davemckelvie/pihat-led-display/pihat-led-display.png

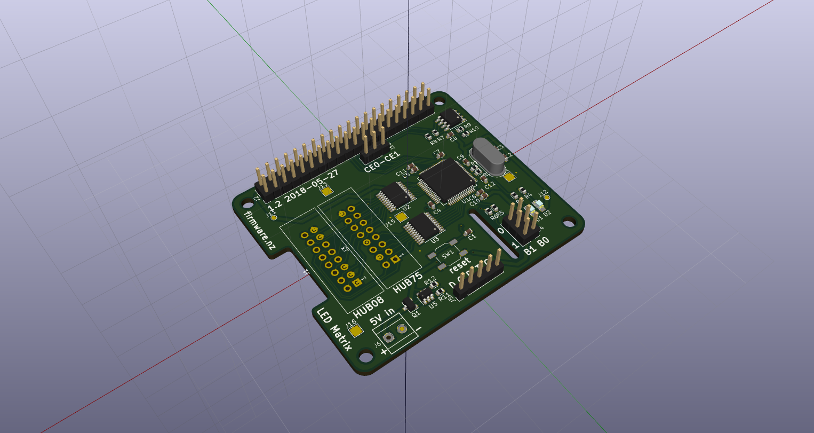
pihat-led-display.png
