davemckelvie/pihat-led-display/pihat-led-display.pdf

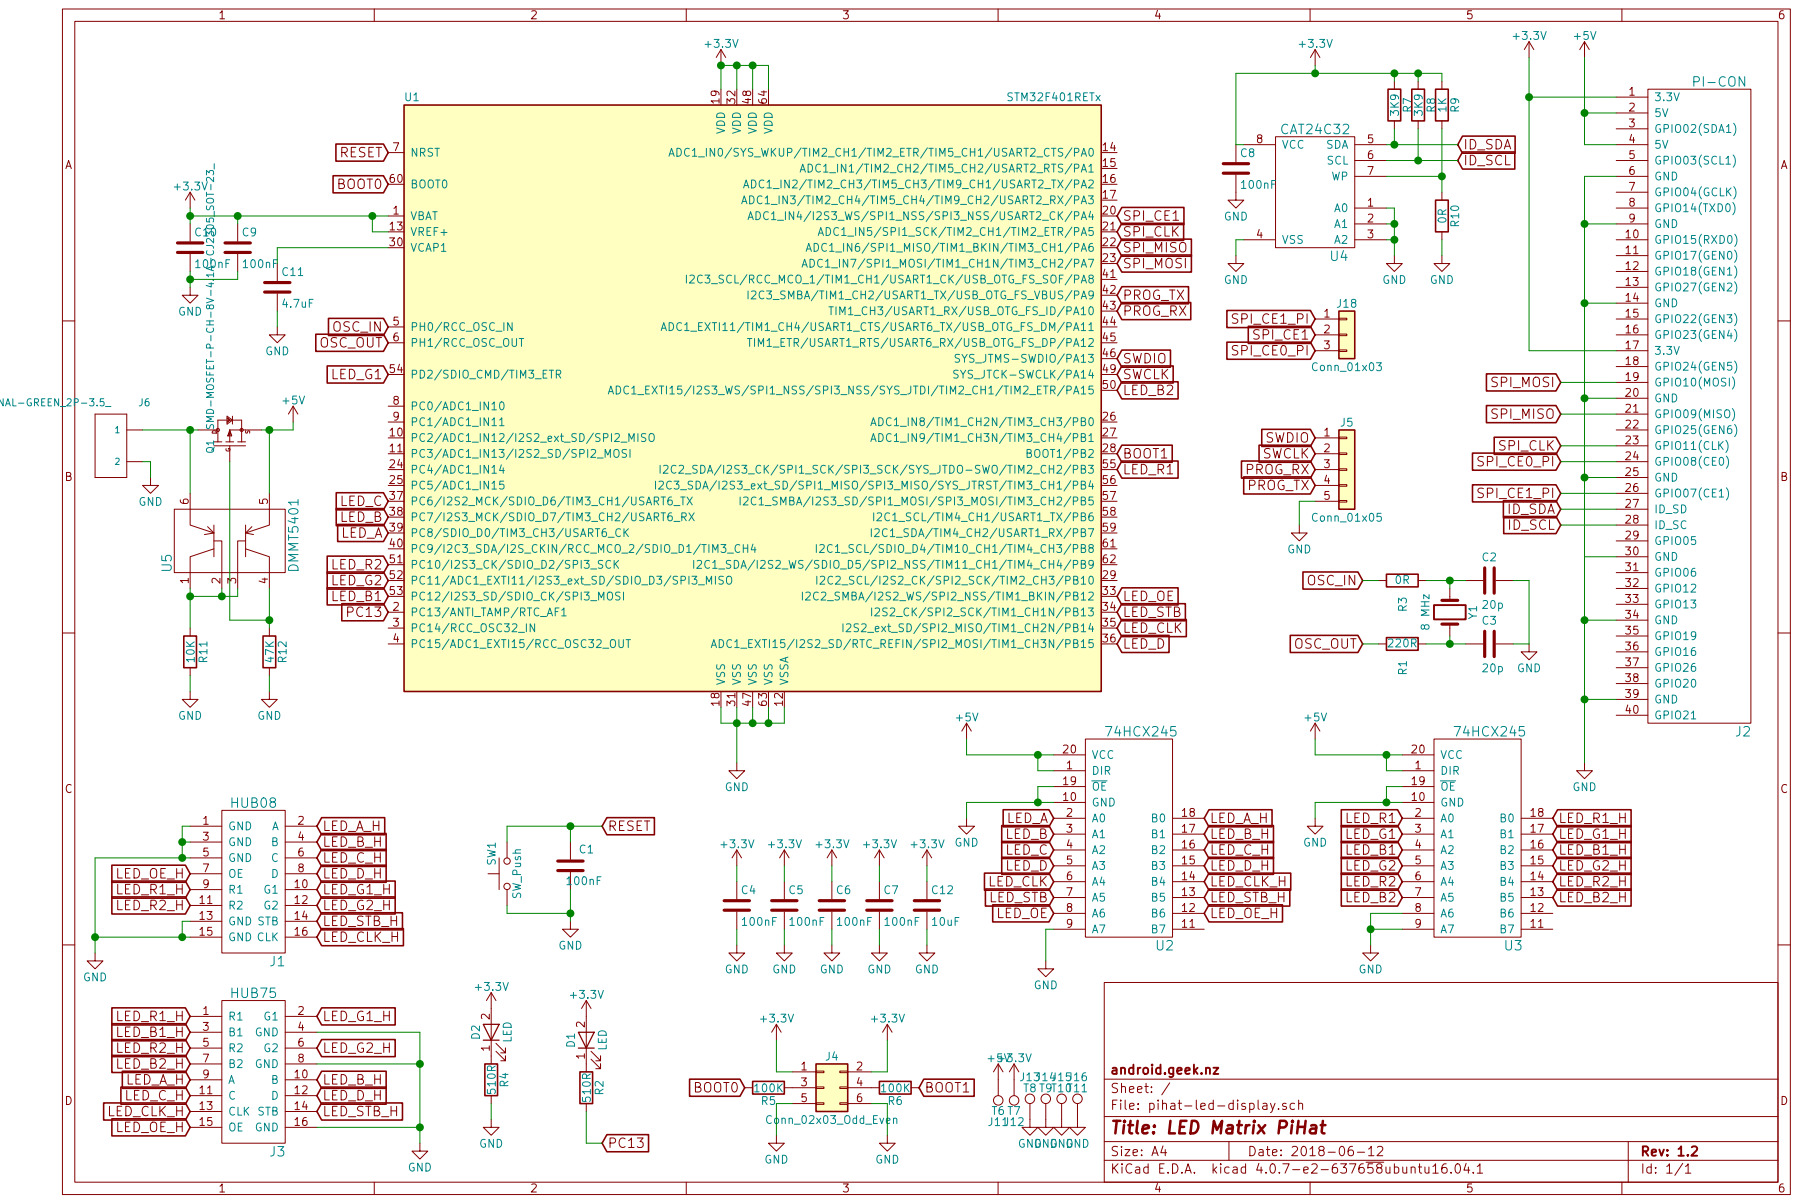
[picture p2: page 1]
