davemckelvie/pihat-led-display/pihat-led-display.kicad_pcb

## KiCad design pihat-led-display.kicad_pcb (2018-08-08)

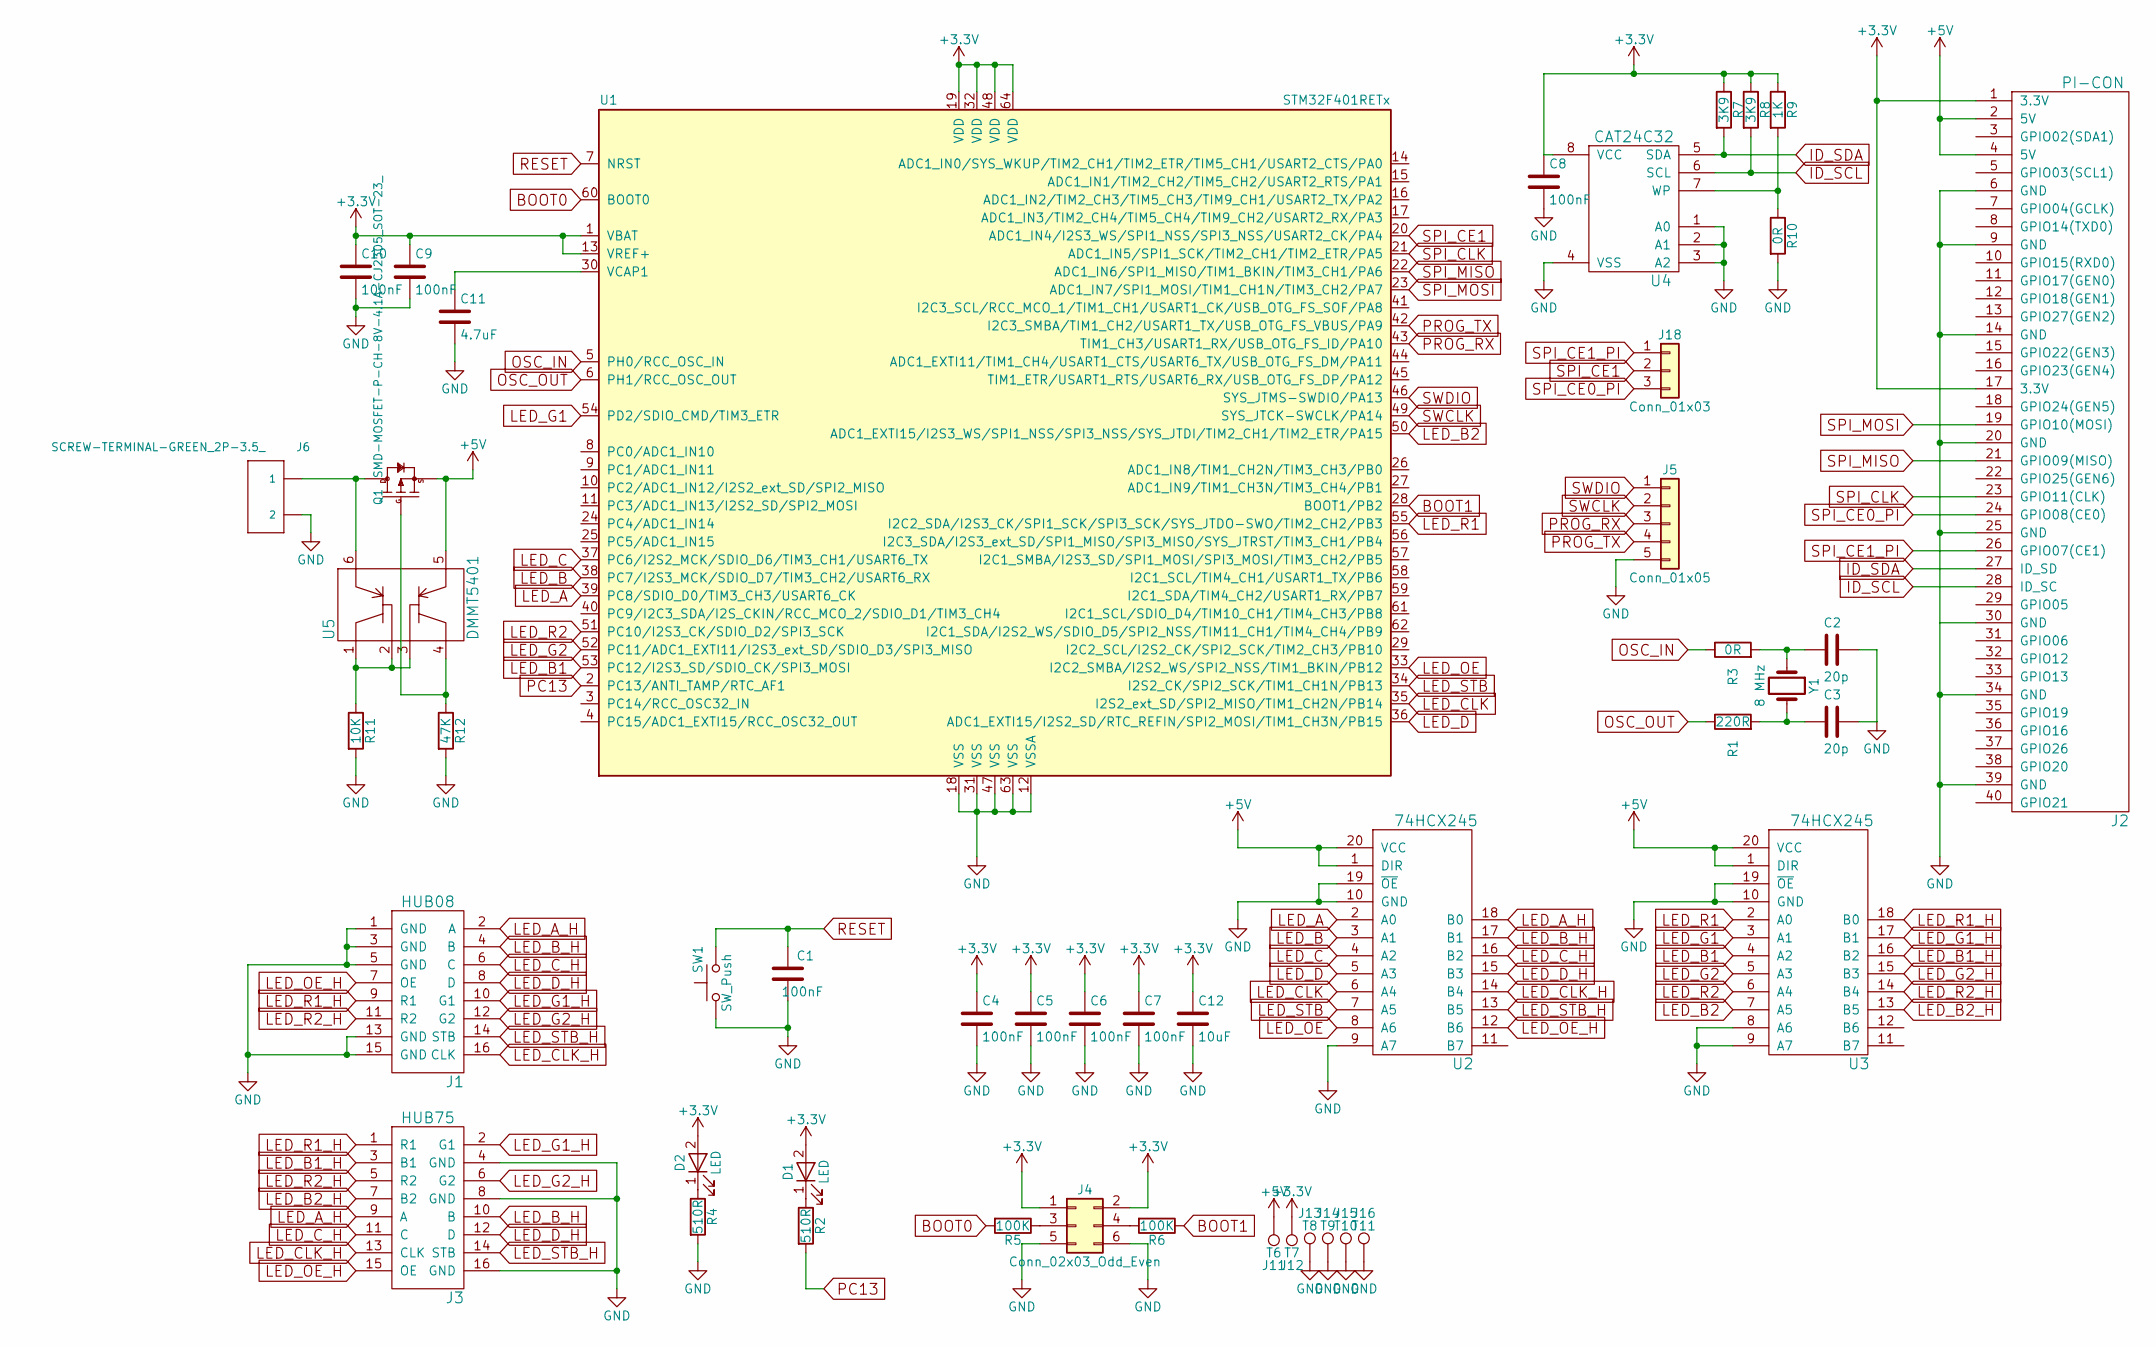
[picture p3: schematic pihat-led-display.sch, LED Matrix PiHat]

Parts:
C1, C4, C5, C6, C7, C8, C9, C10: 100nF; C_0603
C2, C3: 20p; C_0603
C11: 4.7uF; C_0603
C12: 10uF; C_0603
D1, D2: LED; LED_0805
J1: HUB08; IDC-Header_2x08_Pitch2.54mm_Straight
J2: PI-CON; Pin_Header_Straight_2x20_Pitch2.54mm
J3: HUB75; IDC-Header_2x08_Pitch2.54mm_Straight
J4: Conn_02x03_Odd_Even; Pin_Header_Straight_2x03_Pitch2.54mm
J5: Conn_01x05; Pin_Header_Straight_1x05_Pitch2.54mm
J6: SCREW-TERMINAL-GREEN_2P-3.5_; H2-3.5-7.0X7.0MM
J11: T6; Test_Point_Pad_d1.0mm
J12: T7; Test_Point_Pad_d1.0mm
J13: T8; Test_Point_Pad_2.0x2.0mm
J14: T9; Test_Point_Pad_2.0x2.0mm
J15: T10; Test_Point_Pad_2.0x2.0mm
J16: T11; Test_Point_Pad_2.0x2.0mm
J18: Conn_01x03; Pin_Header_Straight_1x03_Pitch2.54mm
Q1: SMD-MOSFET-P-CH-8V-4.1A-CJ2305_SOT-23_; SOT-23; MPN CJ2305
R1: 220R; R_0603
R2, R4: 510R; R_0603
R3, R10: 0R; R_0603
R5, R6: 100K; R_0603
R7, R8: 3K9; R_0603
R9: 1K; R_0603
R11: 10K; R_0603
R12: 47K; R_0603
SW1: SW_Push; SW_SPST_SKQG
U1: STM32F401RETx; LQFP-64_10x10mm_Pitch0.5mm
U2, U3: 74HCX245; TSSOP-20_4.4x6.5mm_Pitch0.65mm
U4: CAT24C32; SOIC-8_3.9x4.9mm_Pitch1.27mm
U5: DMMT5401; SOT-23-6
Y1: 8 MHz; Crystal_HC49-4H_Vertical

Connections:
+3V3: C4.1, C5.1, C6.1, C7.1, C8.1, C9.1, C10.1, C12.1, D1.2 (A), D2.2 (A), J2.1 (3.3V), J2.17 (3.3V), J4.1, J4.2, J12.1, R7.1, R8.1, R9.1, U1.1 (VBAT), U1.13 (VREF+), U1.19 (VDD), U1.32 (VDD), U1.48 (VDD), U1.64 (VDD), U4.8 (VCC)
+5V: J2.2 (5V), J2.4 (5V), J11.1, Q1.2 (S), U2.1 (DIR), U2.20 (VCC), U3.1 (DIR), U3.20 (VCC), U5.5
BOOT0: R5.2, U1.60 (BOOT0)
BOOT1: R6.1, U1.28 (BOOT1/PB2)
GND: C1.1, C2.1, C3.1, C4.2, C5.2, C6.2, C7.2, C8.2, C9.2, C10.2, C11.2, C12.2, J1.1 (GND), J1.3 (GND), J1.5 (GND), J1.13 (GND), J1.15 (GND), J2.6 (GND), J2.9 (GND), J2.14 (GND), J2.20 (GND), J2.25 (GND), J2.34 (GND), J2.39 (GND), J3.4 (GND), J3.8 (GND), J3.16 (GND), J4.5, J4.6, J5.5, J6.2, J13.1, J14.1, J15.1, J16.1, R4.2, R10.2, R11.2, R12.2, SW1.1, U1.12 (VSSA), U1.18 (VSS), U1.31 (VSS), U1.47 (VSS), U1.63 (VSS), U2.9 (A7), U2.10 (GND), U2.19 (~OE), U3.8 (A6), U3.9 (A7), U3.10 (GND), U3.19 (~OE), U4.1 (A0), U4.2 (A1), U4.3 (A2), U4.4 (VSS)
ID_SCL: J2.28 (ID_SC), R8.2, U4.6 (SCL)
ID_SDA: J2.27 (ID_SD), R7.2, U4.5 (SDA)
LED_A: U1.39 (PC8/SDIO_D0/TIM3_CH3/USART6_CK), U2.2 (A0)
LED_A_H: J1.2 (A), J3.9 (A), U2.18 (B0)
LED_B: U1.38 (PC7/I2S3_MCK/SDIO_D7/TIM3_CH2/USART6_RX), U2.3 (A1)
LED_B1: U1.53 (PC12/I2S3_SD/SDIO_CK/SPI3_MOSI), U3.4 (A2)
LED_B1_H: J3.3 (B1), U3.16 (B2)
LED_B2: U1.50 (ADC1_EXTI15/I2S3_WS/SPI1_NSS/SPI3_NSS/S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), U3.7 (A5)
LED_B2_H: J3.7 (B2), U3.13 (B5)
LED_B_H: J1.4 (B), J3.10 (B), U2.17 (B1)
LED_C: U1.37 (PC6/I2S2_MCK/SDIO_D6/TIM3_CH1/USART6_TX), U2.4 (A2)
LED_CLK: U1.35 (I2S2_ext_SD/SPI2_MISO/TIM1_CH2N/PB14), U2.6 (A4)
LED_CLK_H: J1.16 (CLK), J3.13 (CLK), U2.14 (B4)
LED_C_H: J1.6 (C), J3.11 (C), U2.16 (B2)
LED_D: U1.36 (ADC1_EXTI15/I2S2_SD/RTC_REFIN/SPI2_MOSI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), U2.5 (A3)
LED_D_H: J1.8 (D), J3.12 (D), U2.15 (B3)
LED_G1: U1.54 (PD2/SDIO_CMD/TIM3_ETR), U3.3 (A1)
LED_G1_H: J1.10 (G1), J3.2 (G1), U3.17 (B1)
LED_G2: U1.52 (PC11/ADC1_EXTI11/I2S3_ext_SD/SDIO_D3/SP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), U3.5 (A3)
LED_G2_H: J1.12 (G2), J3.6 (G2), U3.15 (B3)
LED_OE: U1.33 (I2C2_SMBA/I2S2_WS/SPI2_NSS/TIM1_BKIN/PB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), U2.8 (A6)
LED_OE_H: J1.7 (OE), J3.15 (OE), U2.12 (B6)
LED_R1: U1.55 (I2C2_SDA/I2S3_CK/SPI1_SCK/SPI3_SCK/SYS_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), U3.2 (A0)
LED_R1_H: J1.9 (R1), J3.1 (R1), U3.18 (B0)
LED_R2: U1.51 (PC10/I2S3_CK/SDIO_D2/SPI3_SCK), U3.6 (A4)
LED_R2_H: J1.11 (R2), J3.5 (R2), U3.14 (B4)
LED_STB: U1.34 (I2S2_CK/SPI2_SCK/TIM1_CH1N/PB13), U2.7 (A5)
LED_STB_H: J1.14 (STB), J3.14 (STB), U2.13 (B5)
unnamed: C2.2, R3.2, Y1.1
unnamed: C3.2, R1.2, Y1.2
unnamed: C11.1, U1.30 (VCAP1)
unnamed: D1.1 (K), R2.1
unnamed: D2.1 (K), R4.1
unnamed: J4.3, R5.1
unnamed: J4.4, R6.2
unnamed: J6.1, Q1.3 (D), U5.6
unnamed: Q1.1 (G), R12.1, U5.4
unnamed: R9.2, R10.1, U4.7 (WP)
unnamed: R11.1, U5.1, U5.2, U5.3
OSC_IN: R3.1, U1.5 (PH0/RCC_OSC_IN)
OSC_OUT: R1.1, U1.6 (PH1/RCC_OSC_OUT)
PC13: R2.2, U1.2 (PC13/ANTI_TAMP/RTC_AF1)
PROG_RX: J5.3, U1.43 (TIM1_CH3/USART1_RX/USB_OTG_FS_ID/PA10)
PROG_TX: J5.4, U1.42 (I2C3_SMBA/TIM1_CH2/USART1_TX/USB_OTG_FS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)
RESET: C1.2, SW1.2, U1.7 (NRST)
SPI_CE0_PI: J2.24 (GPIO08(CE0)), J18.3
SPI_CE1: J18.2, U1.20 (ADC1_IN4/I2S3_WS/SPI1_NSS/SPI3_NSS/USAR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)
SPI_CE1_PI: J2.26 (GPIO07(CE1)), J18.1
SPI_CLK: J2.23 (GPIO11(CLK)), U1.21 (ADC1_IN5/SPI1_SCK/TIM2_CH1/TIM2_ETR/PA5)
SPI_MISO: J2.21 (GPIO09(MISO)), U1.22 (ADC1_IN6/SPI1_MISO/TIM1_BKIN/TIM3_CH1/P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)
SPI_MOSI: J2.19 (GPIO10(MOSI)), U1.23 (ADC1_IN7/SPI1_MOSI/TIM1_CH1N/TIM3_CH2/P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)
SWCLK: J5.2, U1.49 (SYS_JTCK-SWCLK/PA14)
SWDIO: J5.1, U1.46 (SYS_JTMS-SWDIO/PA13)

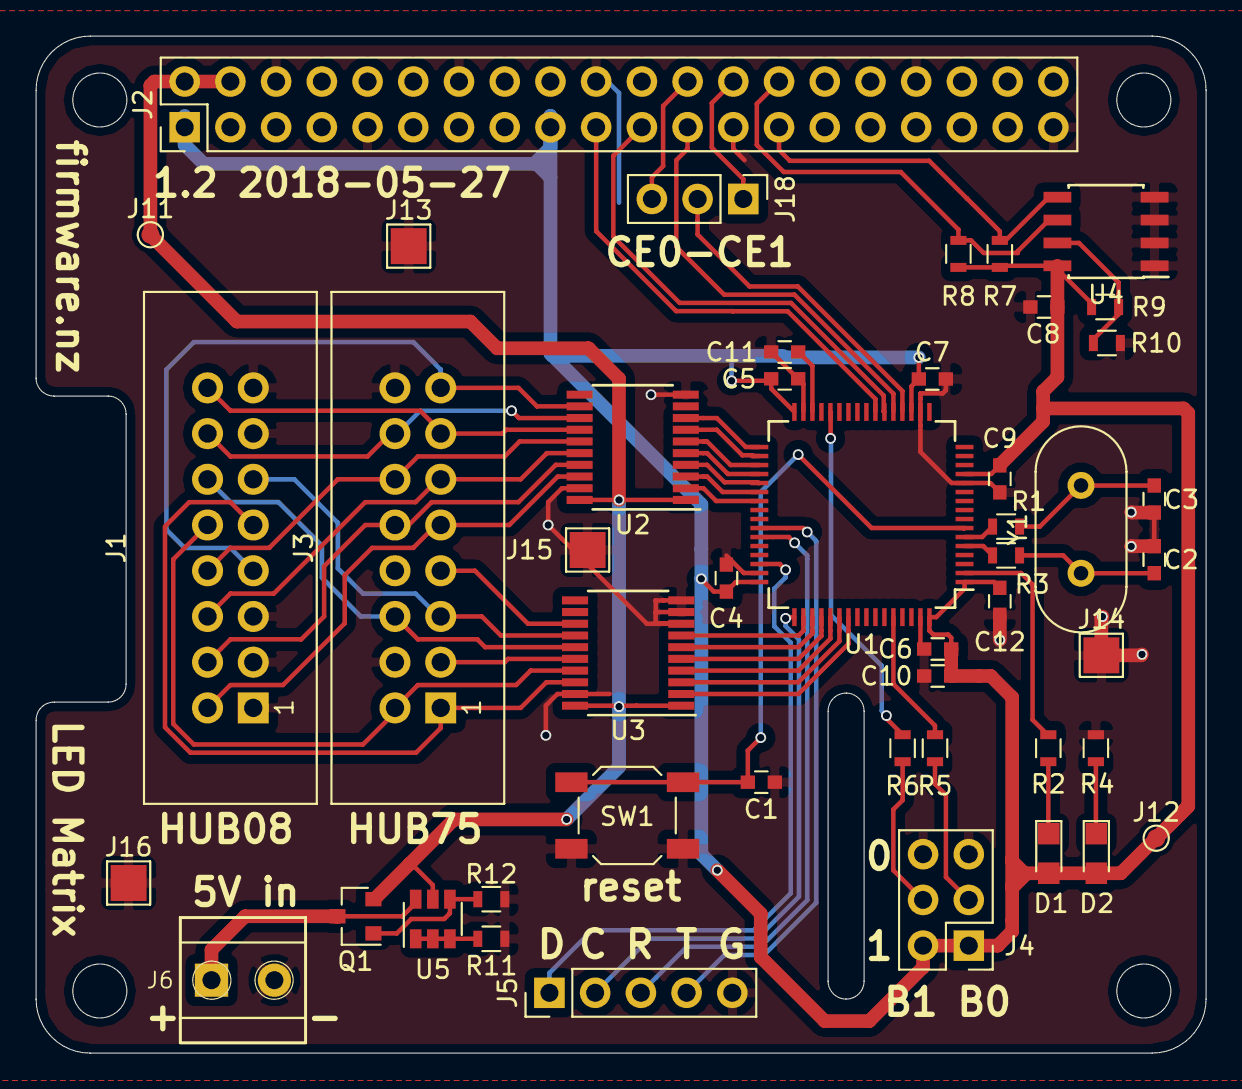
[picture p4: board pihat-led-display.kicad_pcb from above]

Board: 2 copper layers, 65.0 x 56.5 mm, 47 parts (0 on the bottom side), 58 nets.
